chertov/Invertor/README.md

# Инвертор мощностью 2000 Вт с синусом на выходе
Данный проект является полностью открытым и создан с целью изготовить для себя инвертор к солнечным панелям,
а также дать возможность всем желающим самостоятельно изготовить инвертор с отличными параметрами, высокой надежностью
и оптимальной стоимостью.

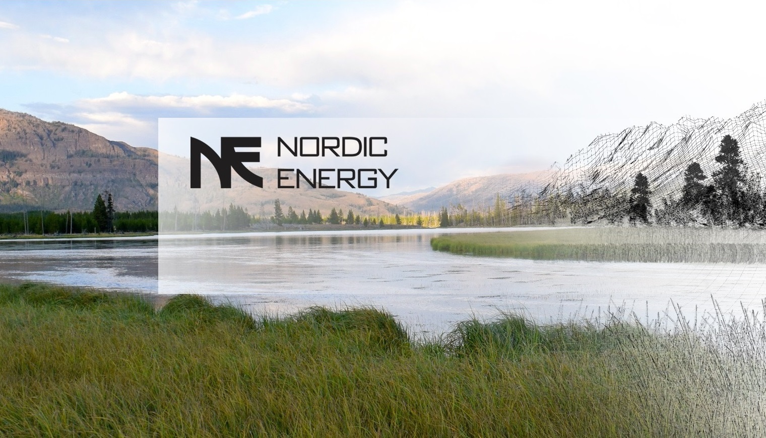
[picture p1: Docs/2.jpg]


# Технические характеристики инвертора:
* Номинальная мощность - не менее 2000 Вт
* Максимальная длительная мощность (не менее 30 мин) - не менее 2200 Вт
* Пиковая мощность (пусковая, не более 20 мс) - 12000 Вт
* Выходное напряжение - 220/230 В
* Входное напряжение - 20,4...28,8 В
* Искажение формы тока - не более 3% при 100% нагрузке
* Отклонение выходного напряжения - не более +-3В при 110% нагрузки
* Интерфейс - Modbus RTU (RS-485)
* Защиты - от КЗ, защита АКБ от глубокого разряда и по току, защита нагрузки от КЗ

# Структура проекта
* Docs - содержит различные файлы с расчетами, документацию и прочее
* Hardware - в ветке находятся проекты связанные с проектированием "железа": печатной платы и корпуса
* Firmware - тут находится исходный код для микроконтроллеров, присутствующих в проекте

# Используемое в проекте ПО
* Altium Designer 17
* SolidWorks 2017
* HyperLynx
* System Workbench

# Лицензирование
Данный проект находится под действием лицензии MIT (Expat). Перед началом работы с проектом и его использованием,
настоятельно рекомендуется ознакомиться с текстом лицензии.

# Связь с создателем проекта
* Электронная почта: hardware.sitara@gmail.com
* Канал на youtube: https://www.youtube.com/channel/UC5By7iwP9gssozXwc2Ydw4A
