chertov/Invertor/Firmware/readme.txt

В данной папке содержится исходный код для STM32, который управляет инвертором.
