chertov/Invertor/Hardware/Mechanical/readme.txt

В данной папке содержатся исходники всех компановок и 3D моделей, как для печатных плат, так и для корпуса.
