chertov/Invertor/Docs/Рассчет трансформатора пуш-пулл.JPG

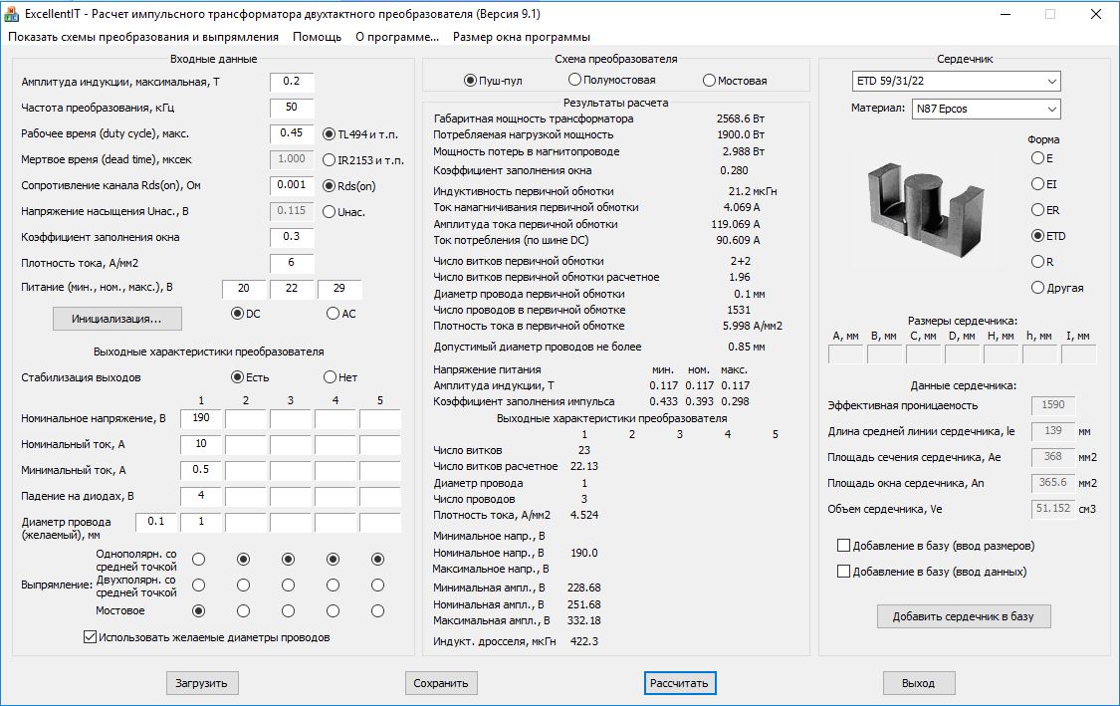
Docs/Рассчет трансформатора пуш-пулл.JPG
