chertov/Invertor/Docs/Расчет выходного дросселя.JPG

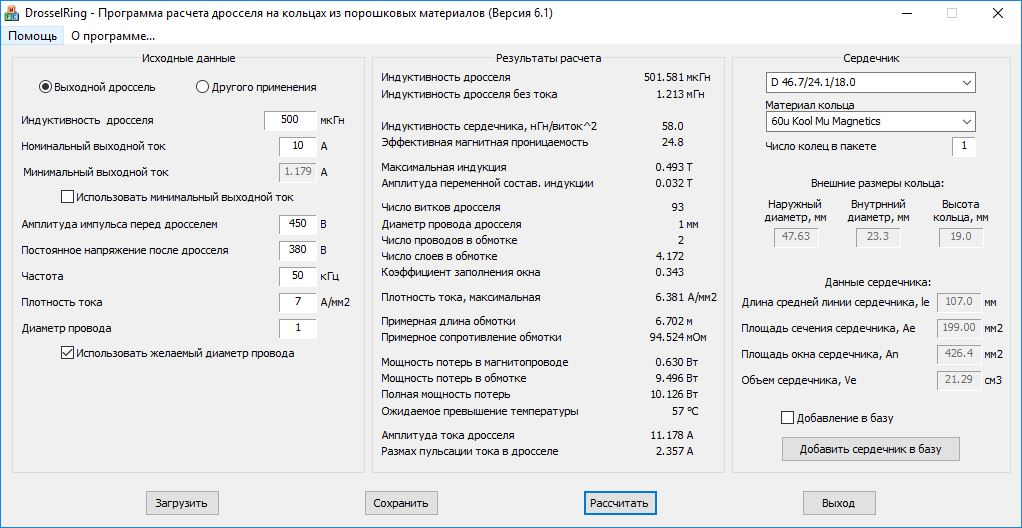
Docs/Расчет выходного дросселя.JPG
