chertov/Invertor/Docs/Расчет флайбека.JPG

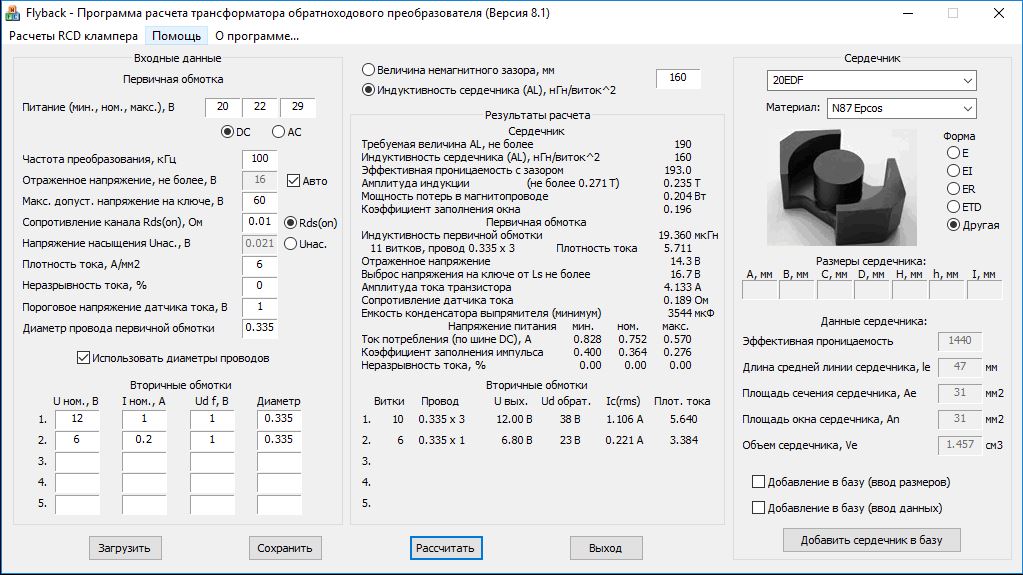
Docs/Расчет флайбека.JPG
