chertov/Invertor/Docs/BOM for invertor 24-380V.xlsx

Comment | Designator | Manufacturer | Model | Quantity | Цена, 1 шт | Цена позиции, руб | Ссылка
470 pF | C1, C19, C21, C34, C36 | Yageo | CC0805KRX7R9BB471 | 5 | 0.28 | 1.4 | http://www.electronshik.ru/item/cc0805krx7r9bb471-823313
2200 μF | C2, C3, C4, C5, C6, C7, C8, C9, C10, C11, C12, C13, C14, C15, C16, C17 | Epcos | B41851F7228M000 | 16 | 68 | 1088 | https://www.chipdip.ru/product0/9000248475
0.1 μF | C18, C20, C22, C24, C28, C35, C37, C39, C49, C50, C67, C68 | Yageo | CC0805KRX7R8BB104 | 12 | 0.37 | 4.44 | http://www.electronshik.ru/item/cc0805krx7r8bb104-325010
1 nF | C23, C38, C65, C66, C70 | Yageo | CC0805KRX7R9BB102 | 5 | 0.25 | 1.25 | http://www.electronshik.ru/item/cc0805krx7r9bb102-328021
1 μF | C25, C40, C69 | Yageo | CC0805KKX7R8BB105 | 3 | 0.68 | 2.04 | http://www.electronshik.ru/item/cc0805kkx7r8bb105-326952
10 μF | C26, C27, C41, C42, C43, C46 | Vishay Sprague | TR3C106K025C0300 | 6 | 22 | 132 | https://www.chipdip.ru/product0/634409749
330 pF | C29 | Yageo | CC0805KKX7R7BB334 | 1 | 0.66 | 0.66 | http://www.electronshik.ru/item/cc0805kkx7r7bb334-358529
680 μF | C30, C31, C32, C33 | EPCOS | B43305B9687M000 | 4 | 234 | 936 | http://ferrite.ru/warehouse/kondensator-680-f-400-v-dc-b43305b9687m000.html
22 μF | C44, C45, C47, C48, C60, C61 | Yageo | CC1206MKX5R7BB226 | 6 | 6.7 | 40.2 | http://www.electronshik.ru/item/cc1206mkx5r7bb226-821735
10 μF | C51, C52, C54, C55 | Yageo | CC1206KKX5R9BB106 | 4 | 10 | 40 | http://www.electronshik.ru/item/cc1206kkx5r9bb106-2097656
22 nF | C53, C56 | Yageo | CC0805KRX7R9BB223 | 2 | 0.28 | 0.56 | http://www.electronshik.ru/item/cc0805krx7r9bb223-312746
220 pF | C57, C58, C59, C62 | Yageo | CC0805KRX7R9BB221 | 4 | 0.3 | 1.2 | http://www.electronshik.ru/item/cc0805krx7r9bb221-608580
4.7 nF | C63 | EPCOS (TDK) | B32021A3472M | 1 | 7.1 | 7.1 | http://ferrite.ru/warehouse/kondensator-0.0047-f-20-300-v-ac-b32021a3472m189.html
10 μF | C64 | Yageo | CC0805KKX5R7BB106 | 1 | 1.6 | 1.6 | http://www.electronshik.ru/item/cc0805kkx5r7bb106-1036494
MCP6541T | D1, D2, D6, D15, D16 | Microchip Technology | MCP6541T-I/OT | 5 | 22.4 | 112 | http://www.electronshik.ru/item/mcp6541t-iot-180278
MCP6001T | D3, D7 | Microchip Technology | MCP6001T-I/OT | 2 | 15 | 30 | http://www.electronshik.ru/item/mcp6001t-iot-312159
IR25750LTRPBF | D4, D8 | Infineon Technologies | IR25750LTRPBF | 2 | 18.2 | 36.4 | http://www.electronshik.ru/item/ir25750ltrpbf-1331775
UCC27322D | D5, D9 | Texas Instruments | UCC27322D | 2 | 197 | 394 | http://www.electronshik.ru/item/ucc27322d-287357
L5973AD | D10, D11 | STMicroelectronics | L5973AD | 2 | 96 | 192 | http://www.electronshik.ru/item/l5973adtr-301159
NCP1117ST50T3G | D12 | ON Semiconductor | NCP1117ST50T3G | 1 | 12.8 | 12.8 | http://www.electronshik.ru/item/ncp1117st50t3g-334394
TMA-0505S | D13 | Traco Power | TMA-0505S | 1 | 240 | 240 | https://www.chipdip.ru/product/tma0505s
TL598CDR | D14 | Texas Instruments | TL598CDR | 1 | 87.5 | 87.5 | http://www.electronshik.ru/item/tl598cd-179052
120R | FB1 | Murata Electronics North America | BLM21PG121SN1D | 1 | 1.5 | 1.5 | http://www.electronshik.ru/item/blm21pg121sn1d-675317
500 μH | L1 | Magnetics | 0077439A7 | 1 | 220.41 | 220.41 | http://ferrite.ru/warehouse/r-46-724-118-77439-a7.html
22 μH | L2, L3 | Bourns Inc. | SDR0604-220YL | 2 | 36 | 72 | https://www.chipdip.ru/product/sdr0604-220yl
5k6 | R1 | Yageo | RC0805FR-075K6L | 1 | 0.12 | 0.12 | http://www.electronshik.ru/item/rc0805fr-075k6l-361851
100k | R2 | Yageo | RC0805FR-07100KL | 1 | 0.14 | 0.14 | http://www.electronshik.ru/item/rc0805fr-07100kl-359706
100R | R3, R12, R13, R22, R41, R42, R49, R67, R69 | Yageo | RC0805JR-07100RL | 9 | 0.1 | 0.9 | http://www.electronshik.ru/item/rc0805jr-07100rl-353447
10k | R4, R8, R11, R35, R36, R40 | Yageo | RC0805FR-0710KL | 6 | 0.13 | 0.78 | http://www.electronshik.ru/item/rc0805fr-0710kl-358763
3k3 | R5 | Yageo | RC0805FR-073K3L | 1 | 0.15 | 0.15 | http://www.electronshik.ru/item/rc0805fr-073k3l-367820
13k | R6, R33 | Yageo | RC0805FR-0713KL | 2 | 0.12 | 0.24 | http://www.electronshik.ru/item/rc0805fr-0713kl-569843
1k | R7, R9, R32, R34, R38, R66, R68, R80, R81, R82 | Yageo | RC0805JR-071KL | 10 | 0.1 | 1 | http://www.electronshik.ru/item/rc0805jr-071kl-559515
1k | R10, R39, R64, R65 | Yageo | RC0805FR-071KL | 4 | 0.12 | 0.48 | http://www.electronshik.ru/item/rc0805fr-071kl-564131
560k | R14, R23 | Yageo | RC0805FR-07510KL | 2 | 0.11 | 0.22 | http://www.electronshik.ru/item/rc0805fr-07510kl-665333
220R | R15 | Yageo | RC0805JR-07220RL | 1 | 0.09 | 0.09 | http://www.electronshik.ru/item/rc0805jr-07220rl-543043
2R2 | R16, R17, R18, R19, R20, R21, R43, R44, R45, R46, R47, R48 | Yageo | RC0805FR-075R1L | 12 | 0.11 | 1.32 | http://www.electronshik.ru/item/rc0805fr-075r1l-871825
10k | R24, R25, R26, R27, R28, R29, R30, R31, R50, R51, R52, R53, R54, R55, R56, R63, R72, R73, R76, R77, R79 | Yageo | RC0805JR-0710KL | 21 | 0.11 | 2.31 | http://www.electronshik.ru/item/rc0805jr-0710kl-339147
10k | R37, R74, R75 | Bourns Inc. | 3296W-1-103LF | 3 | 43.6 | 130.8 | http://www.electronshik.ru/item/3296w-1-103lf-132155
43k | R57 | Yageo | RC0805FR-0743KL | 1 | 0.12 | 0.12 | http://www.electronshik.ru/item/rc0805fr-0743kl-328616
20k | R58 | Yageo | RC0805FR-0720KL | 1 | 0.12 | 0.12 | http://www.electronshik.ru/item/rc0805fr-0720kl-362740
4k7 | R59, R60, R61, R62, R70, R71, R78 | Yageo | RC0805FR-074K7L | 7 | 0.13 | 0.91 | http://www.electronshik.ru/item/rc0805fr-074k7l-341758
220k | R83 | Yageo | RC2512JK-07150KL | 1 | 1.1 | 1.1 | http://www.electronshik.ru/item/rc2512jk-07150kl-1133442
ETD59/31/22 | T1, T2 | Epcos | ETD59/31/22 | 2 | 332.9 | 665.8 | http://ferrite.ru/warehouse/etd-59-31-22-serdechnik-b66397g0000x187.html
LTV-817S | U1 | Lite-On Inc. | LTV-817S | 1 | 9.4 | 9.4 | http://www.electronshik.ru/item/ltv-817s-178730
MMSZ5231B | VD1 | Fairchild/ON Semiconductor | MMSZ5231B | 1 | 2.1 | 2.1 | http://www.electronshik.ru/item/mmsz5248bt1g-297702
SS24FL | VD2, VD5, VD6, VD7, VD8, VD9, VD10, VD12, VD27, VD30, VD31, VD32, VD33, VD34, VD35, VD37 | Fairchild/ON Semiconductor | SS24FL | 16 | 16 | 256 | https://www.chipdip.ru/product1/8689956362
SMBJ40A | VD3, VD4, VD28, VD29 | Fairchild/ON Semiconductor | SMBJ40A | 4 | 4.4 | 17.6 | http://www.electronshik.ru/item/smbj40a-1185903
SD15C-01FT | VD11, VD36, VD13, VD14, VD15, VD16, VD17, VD38, VD39, VD40, VD41, VD42 | Littelfuse Inc. | SD15C-01FTG | 12 | 5.9 | 70.8 | http://www.electronshik.ru/item/sd15c-01ftg-1398020
HFA15TB60PBF | VD18, VD19, VD20, VD21, VD23, VD24, VD25, VD26 | Infineon Technologies | HFA15TB60PBF | 8 | 45 | 360 | https://www.chipdip.ru/product/hfa15tb60
TL431AIDBZR | VD22 | Texas Instruments | TL431AIDBZR | 1 | 7.2 | 7.2 | http://www.electronshik.ru/item/tl431aidbzr-181531
STPS2L60A | VD43, VD44 | STMicroelectronics | STPS2L60A | 2 | 9.3 | 18.6 | http://www.electronshik.ru/item/stps2l60a-145504
RED | VD45 | Wurth Electronics Inc. | 150080RS75000 | 1 | 4 | 4
GREEN | VD46, VD47 | Wurth Electronics Inc. | 150080VS75000 | 2 | 4 | 8
IPP083N10N5 | VT1, VT2, VT3, VT4, VT5, VT6, VT7, VT8, VT9, VT10, VT11, VT12 | Infineon Technologies | IPP083N10N5AKSA1 | 12 | 105.31 | 1263.72 | http://www.electronshik.ru/item/ipp083n10n5aksa1-2115675
BC857BLT1G | VT13, VT16 | ON Semiconductor | BC857BLT1G | 2 | 0.76 | 1.52 | http://www.electronshik.ru/item/bc857blt1g-340291
IRLML0030TRPBF | VT14, VT15 | Infineon Technologies | IRLML0030TRPBF | 2 | 6.5 | 13 | http://www.electronshik.ru/item/irlml0030trpbf-545264
Разъем | X1, X2 | Wurth Electronics Inc. | 7461383 | 2 | 230 | 460 | https://www.chipdip.ru/product/7461383-1
Разъем | X3, X4, X5, X6 | Ningbo Zhenqin Electronic | WF-02 | 4 | 8 | 32 | https://www.chipdip.ru/product/wf-2?utm_source=chipdip&utm_medium=recommend&utm_campaign=rec_product
Разъем | X7 | Ningbo Zhenqin Electronic | X977B02 | 1 | 14 | 14 | https://www.chipdip.ru/product/x977b02
 |  |  |  |  | Итог: | 6999.6
