chertov/Invertor/Hardware/Mechanical/AB3884.SLDPRT

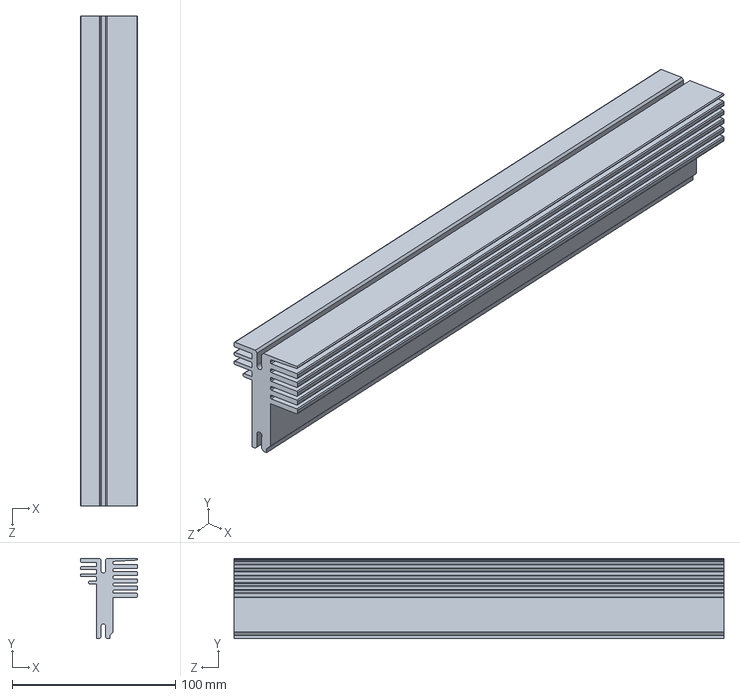
[picture p5: CAD file, 2017-10-31]
Hardware/Mechanical/AB3884.SLDPRT
35.0 x 49.0 x 300.0 mm
