chertov/Invertor/Docs/Инвертор 24-380В.pdf

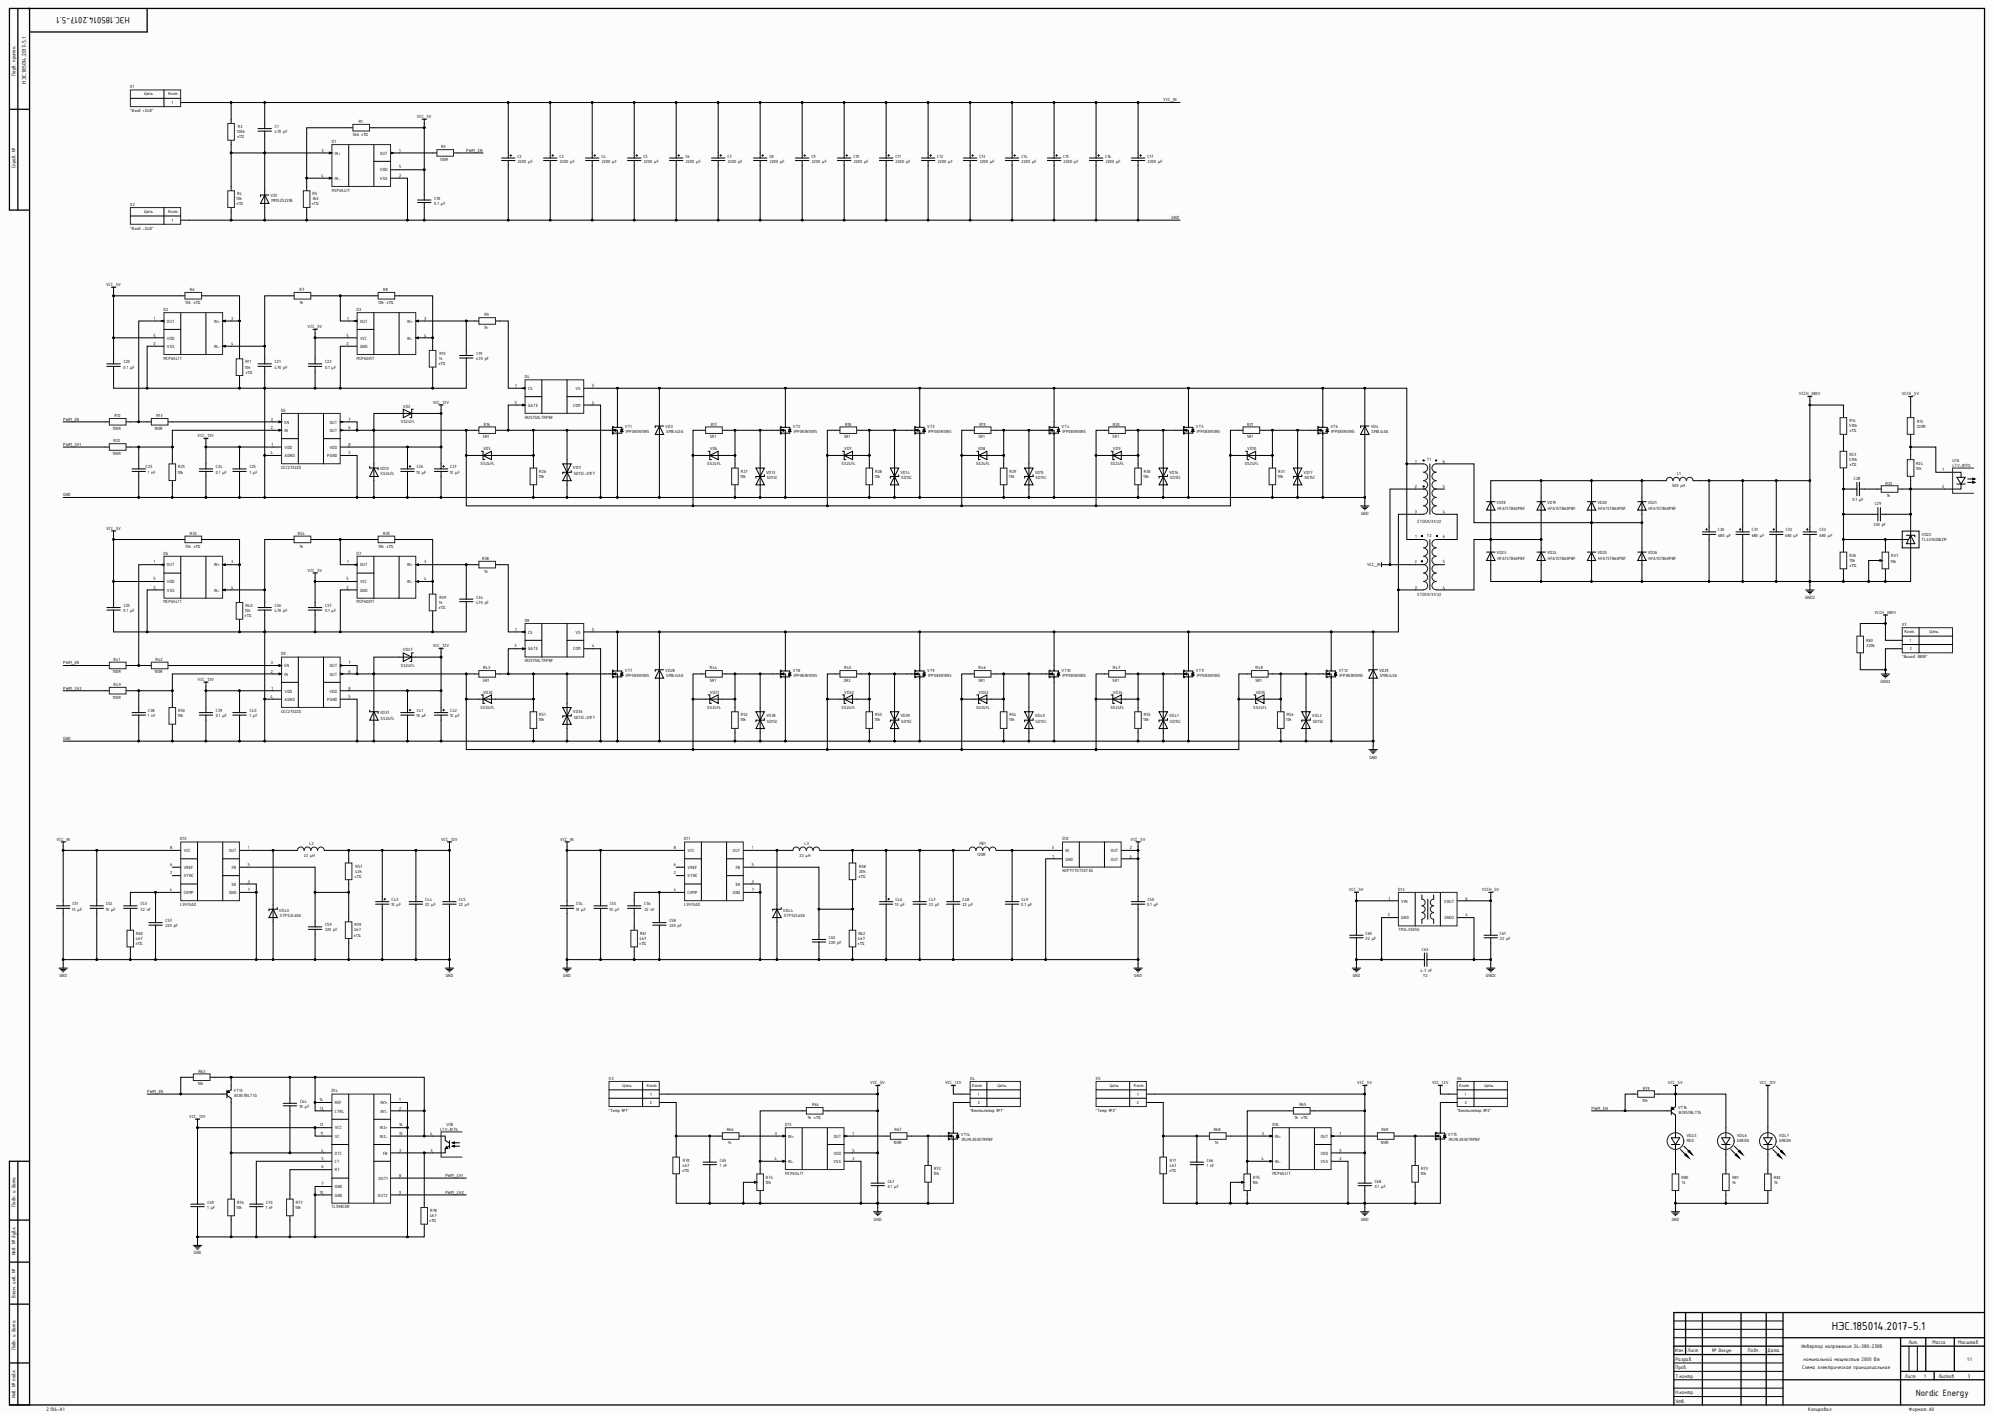
[picture p6: page 1]

Инв. № подл. Инв. № дубл. Подп. и дата Взам. инв. № Подп. и дата Перв. примен. Справ. №

Цепь | Конт.

Конт. | Цепь

GND 7

PWM_CH2

НЭС.185014.2017-5.1

Инвертор напряжения 24-380-230В номинальной мощностью 2000 Вт Схема электрическая принципиальная | Лит. | Масса | Масштаб

Изм. | Лист | № докум. | Подп. | Дата | | | | | 1:1
Разраб.
Пров.
Т.контр. | | | | | Лист 1 | Листов 3

Nordic Energy

Н.контр.
Утв.
