chertov/Invertor/(list of files, drawings)

Other design files:
Hardware/PCB/Invertor 24-380V/Invertor 24-380V.PrjPcb
Hardware/PCB/Invertor 24-380V/Page 1.SchDoc
