chertov/Invertor/(commit log)

2017-10-19 creating project
    [Invertor 2000W.PrjPcb, PCB for invertor.PcbDoc, Page 1.SchDoc, Page 2.SchDoc]
2017-10-24 rev.1.001: adding final schematic and BOM
    [BOM для инвертора.xlsx, Invertor 2000W.PrjPcb, Page 1.SchDoc, Page 2.SchDoc, Page 3.SchDoc]
2017-10-30 rev.1.001: upload schematic and BOM for new concept
    [BOM for invertor 24-380V.xlsx, BOM для инвертора.xlsx, Invertor 2000W.PrjPcb, Invertor 24-380V.PrjPcb, PCB for invertor.PcbDoc, Page 1.SchDoc, Page 2.SchDoc, Page 3.SchDoc]
2017-10-31 rev.1.001: adding PCB board file and Gerber file for invertor 24-380V
    [AB3884.SLDPRT, BOM for invertor 24-380V.xlsx, Invertor 24-380V.PrjPcb, Page 1.SchDoc]
2017-10-31 delet excess schematic. Page 2
    [Page 2.SchDoc]
2017-10-31 delet excess schematic. Page 3
    [Page 3.SchDoc]
2017-10-31 rev.1.001: adding logo for PCB
    [Invertor 24-380V.PrjPcb]
2017-11-04 rev.1.001: update PCB file for assembly layer
    [Invertor 24-380V.PrjPcb]
